devel0/iot-maple-mini-serial-grbl-fwd/data/doc/BREAKOUT_BOARD.pdf

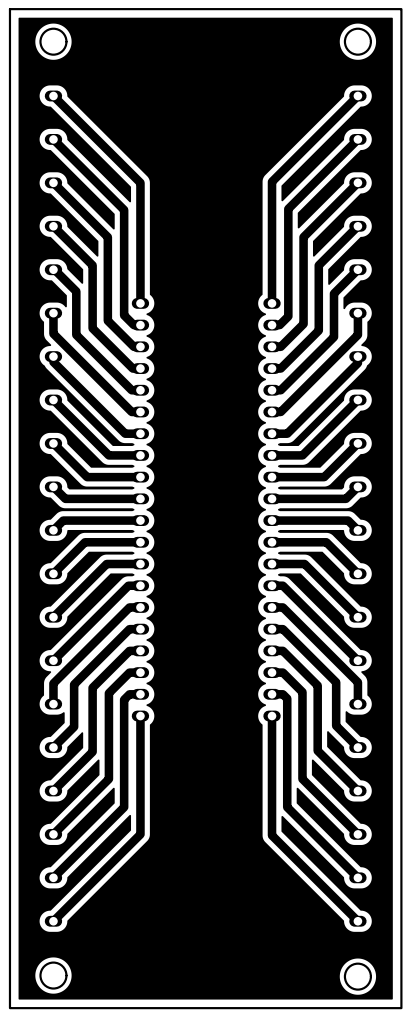
[picture p3: page 1]
