devel0/iot-maple-mini-serial-grbl-fwd/(commit log)

2020-11-07 dev0.3 branch
    [config.h]
2020-11-07 use of MARLIN_BUFSIZE
2020-11-07 fix strncmp usage in detection G90/G91 state tracking
    [Global.cpp]
2020-11-07 resume print
2020-11-07 fix resume to exec XY positioning then Z
    [Global.cpp]
2020-11-08 sdcard init fail message; added check for /ls
    [Global.cpp]
2020-11-08 compile time /home, /zero scripts
    [config.h]
2020-11-08 refactored state machine
    [config.h]
2020-11-08 v0.4 - tool change handling
    [config.h]
2020-11-08 code cleanup
    [config.h]
2020-11-10 speed 100 and feed 2000mm/min in homing
    [config.h]
2020-11-10 baudrate 230400 instead of 1Mbaud to reduce chance of loose char on stm32
    [config.h]
2021-01-27 toolzdiff - todo: check /send lost of fwdstate nfo
    [config.h]
2021-01-27 speed 115200
    [config.h]
